ndipatri/RoboGaggia/MyApplication/gaggia1.jpg

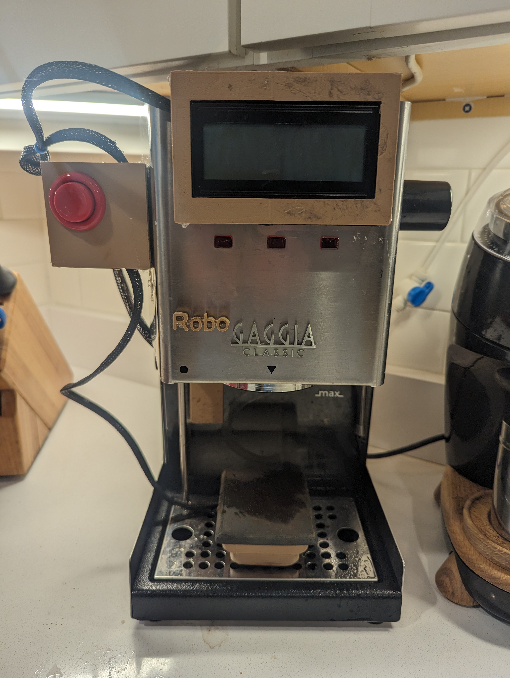
MyApplication/gaggia1.jpg
