ndipatri/RoboGaggia/3DPrints/gaggiaPhoneMount_disk.stl

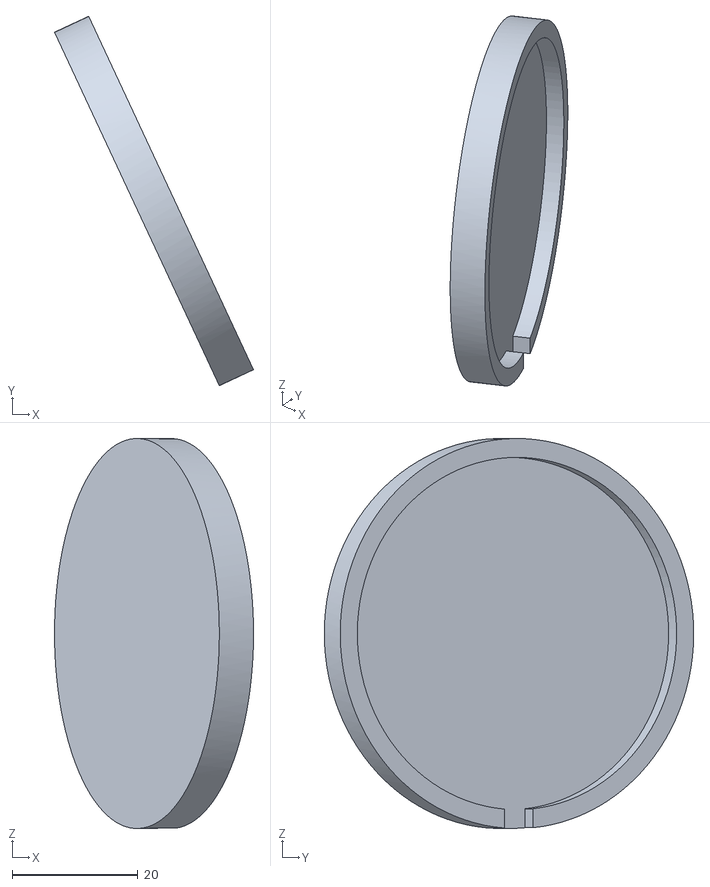
[picture p12: CAD file, 2025-05-02]
3DPrints/gaggiaPhoneMount_disk.stl
31.6 x 58.7 x 62.0
