ndipatri/RoboGaggia/3DPrints/gaggiaPhoneMount_body.stl

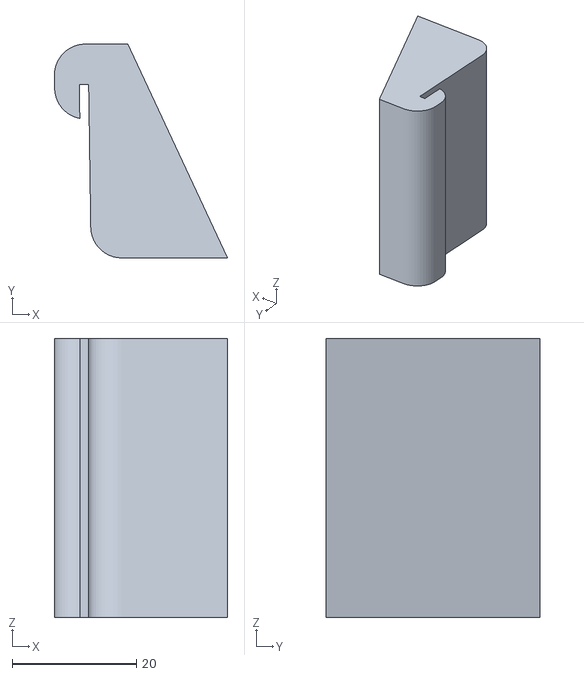
[picture p13: CAD file, 2025-05-02]
3DPrints/gaggiaPhoneMount_body.stl
27.9 x 34.5 x 45.0
