ndipatri/RoboGaggia/3DPrints/gaggiaArmature.stl

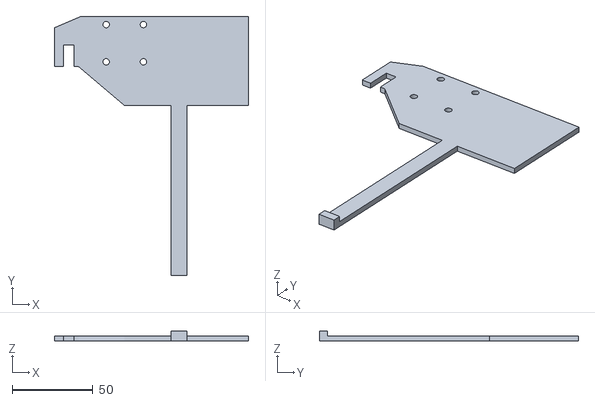
[picture p14: CAD file, 2025-05-02]
3DPrints/gaggiaArmature.stl
120.0 x 160.0 x 6.00
