ndipatri/RoboGaggia/3DPrints/gaggia3PCB_internalSupport.stl

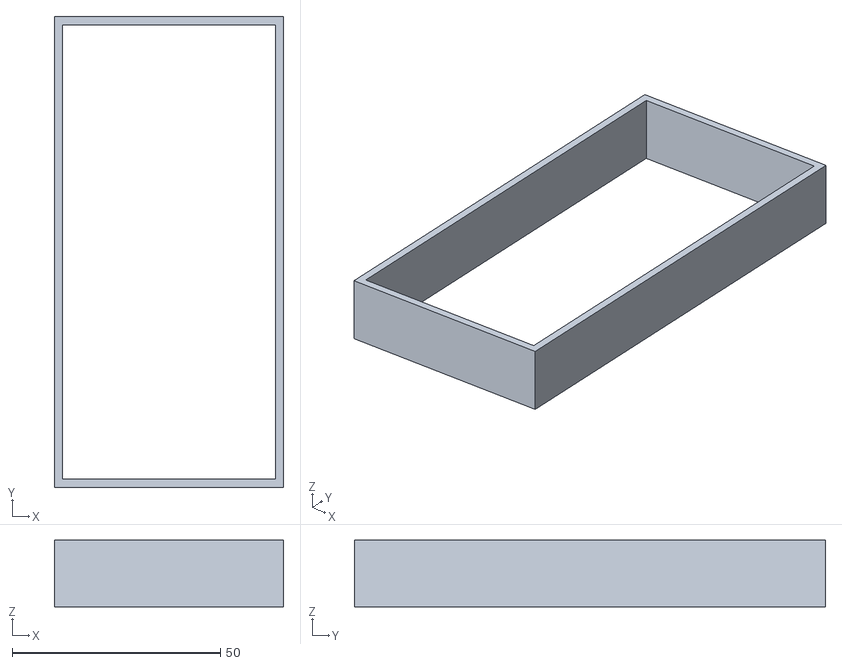
[picture p15: CAD file, 2025-05-02]
3DPrints/gaggia3PCB_internalSupport.stl
55.0 x 113.0 x 16.0
