ndipatri/RoboGaggia/3DPrints/gaggia3Power_lid.stl

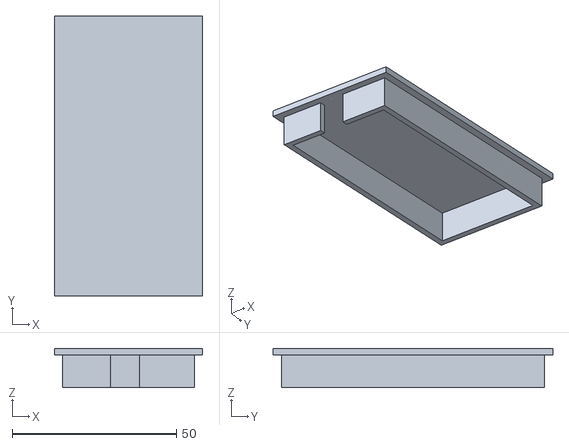
[picture p16: CAD file, 2025-05-02]
3DPrints/gaggia3Power_lid.stl
45.0 x 85.0 x 12.0
