ndipatri/RoboGaggia/3DPrints/gaggia3PCB_lid.stl

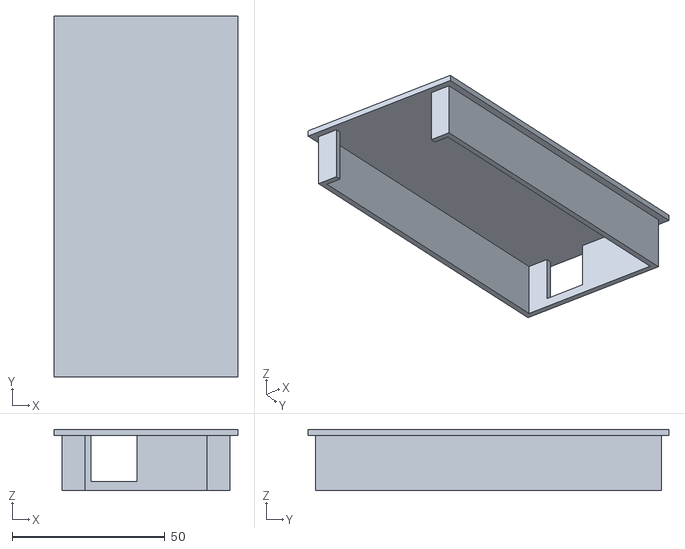
[picture p17: CAD file, 2025-05-02]
3DPrints/gaggia3PCB_lid.stl
60.0 x 118.0 x 20.0
