ndipatri/RoboGaggia/3DPrints/gaggiaPCB.stl

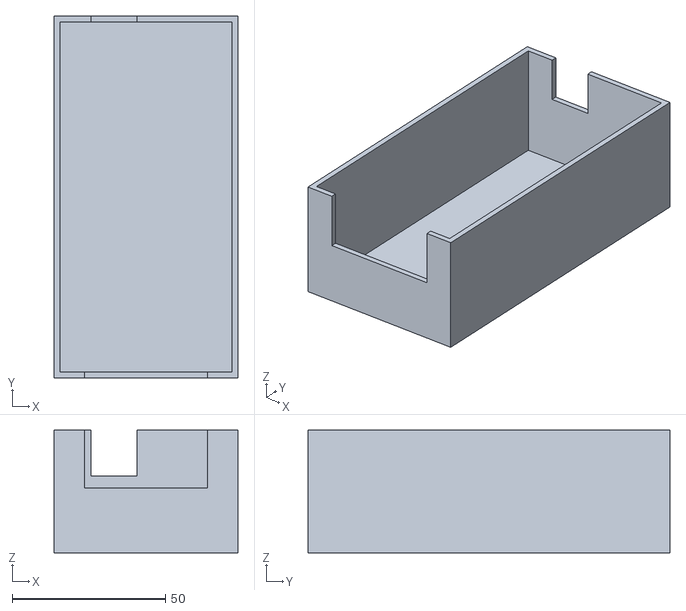
[picture p18: CAD file, 2025-05-02]
3DPrints/gaggiaPCB.stl
60.0 x 118.0 x 40.0
