ndipatri/RoboGaggia/3DPrints/gaggia3Power.stl

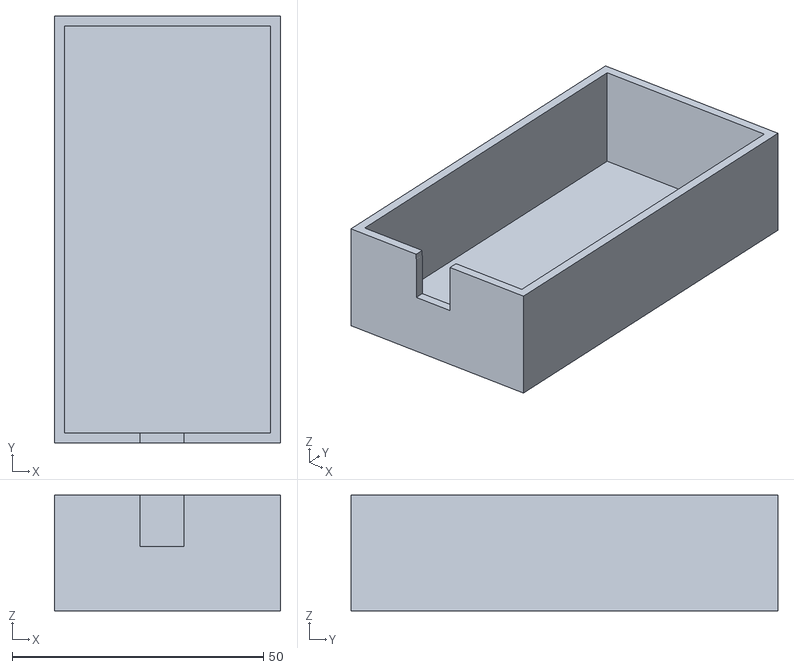
[picture p19: CAD file, 2025-05-02]
3DPrints/gaggia3Power.stl
45.0 x 85.0 x 23.0
