ndipatri/RoboGaggia/3DPrints/scaleTop.stl

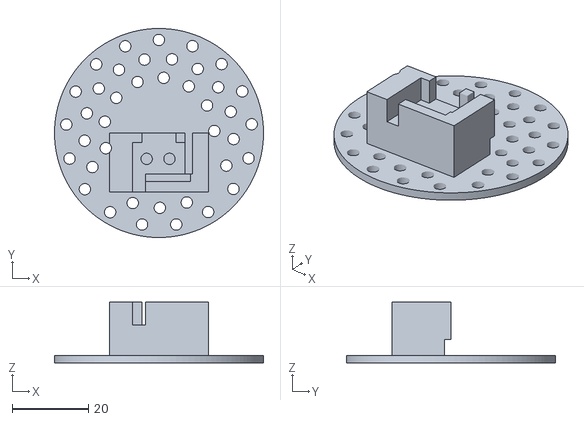
[picture p20: CAD file, 2024-08-15]
3DPrints/scaleTop.stl
55.0 x 55.0 x 16.0
