ndipatri/RoboGaggia/3DPrints/scaleBottom.stl

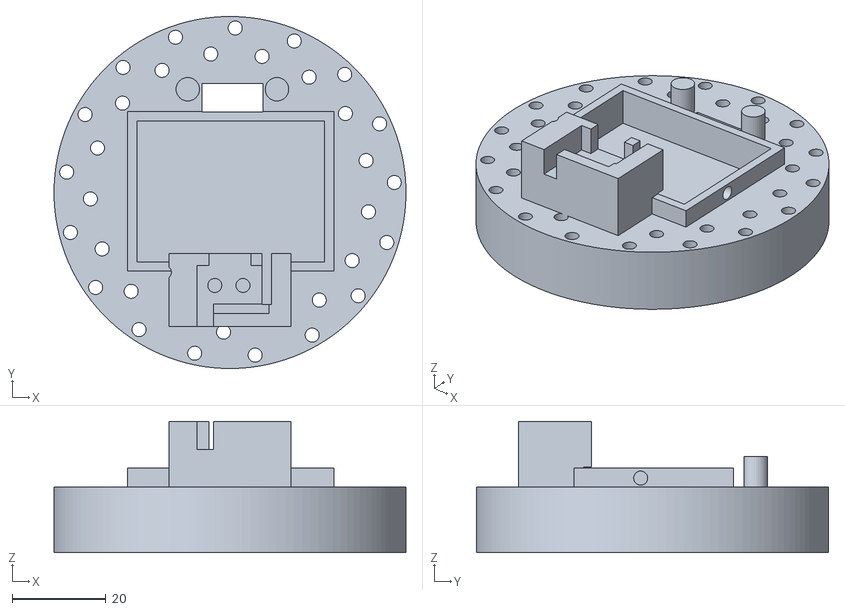
[picture p21: CAD file, 2024-08-15]
3DPrints/scaleBottom.stl
75.0 x 75.0 x 28.0
