ndipatri/RoboGaggia/3DPrints/waterSensorMount.stl

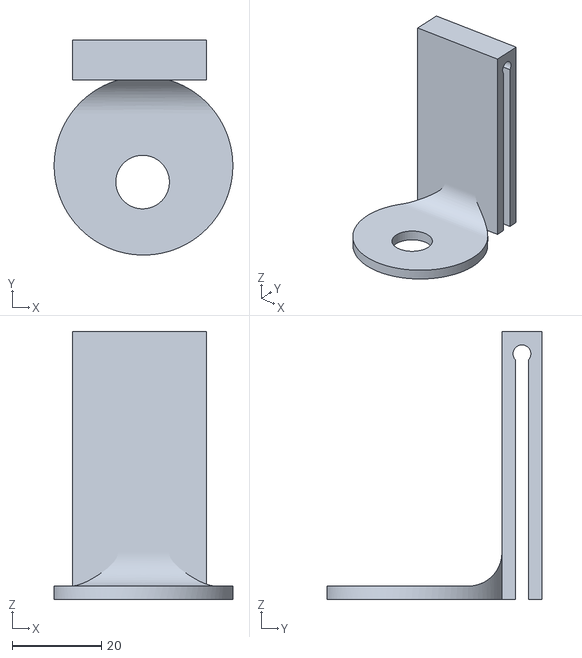
[picture p22: CAD file, 2023-02-01]
3DPrints/waterSensorMount.stl
40.0 x 48.2 x 60.0
