ndipatri/RoboGaggia/3DPrints/valveHanger.stl

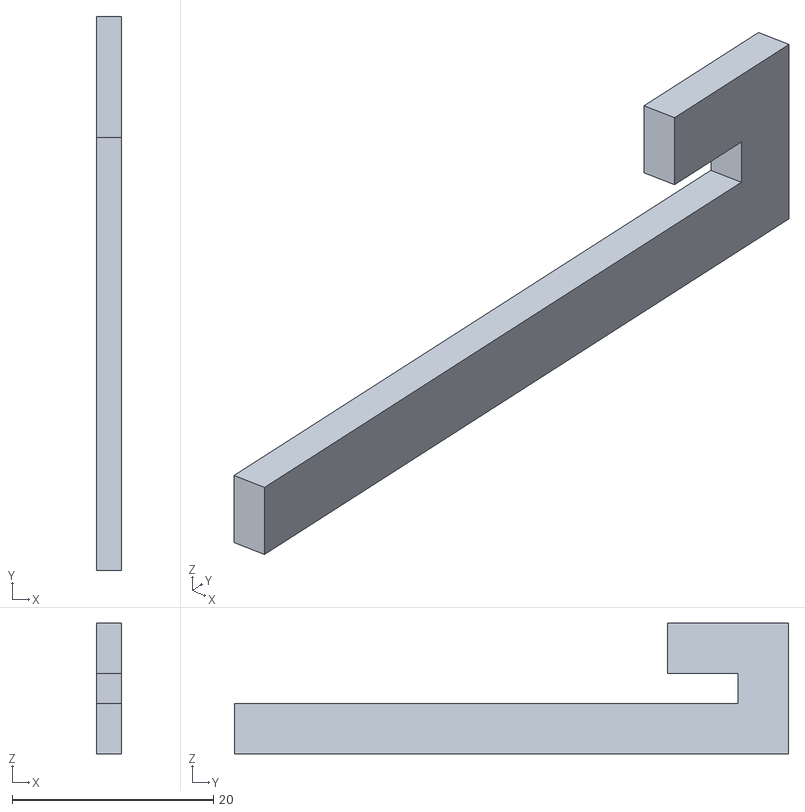
[picture p23: CAD file, 2022-10-07]
3DPrints/valveHanger.stl
2.50 x 55.0 x 13.0
