ndipatri/RoboGaggia/3DPrints/valveBody.stl

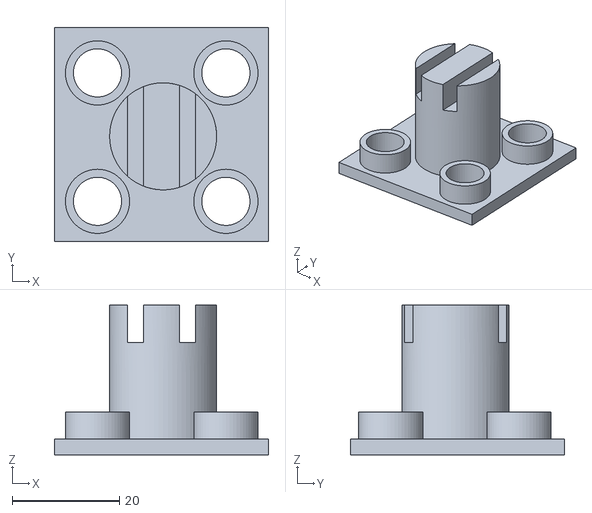
[picture p24: CAD file, 2022-10-07]
3DPrints/valveBody.stl
40.0 x 40.0 x 28.0
