ndipatri/RoboGaggia/media/pressureCalibration.png

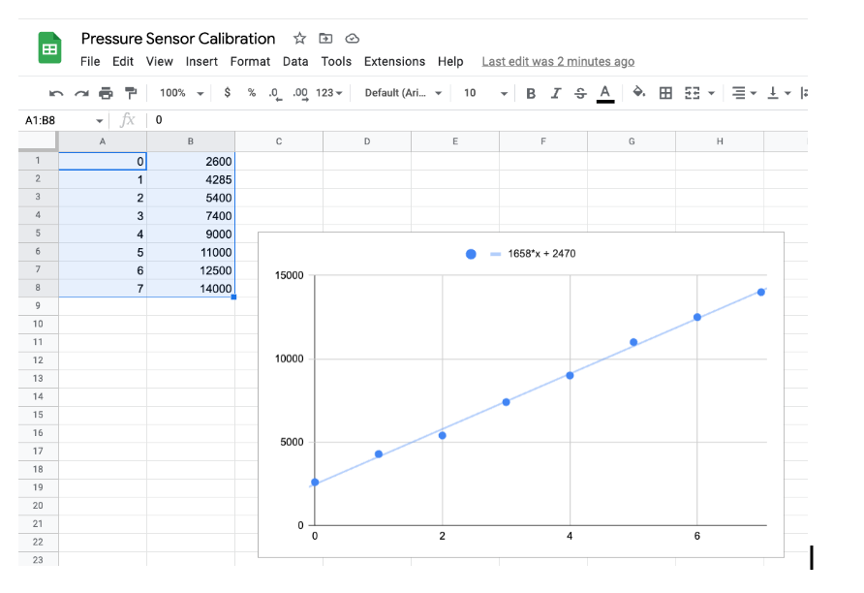
media/pressureCalibration.png
