ndipatri/RoboGaggia/src/components/Common.h

#ifndef CORE_H
#define CORE_H

#include <Arduino.h>

enum GaggiaStateEnum {
  SLEEP,
  PREHEAT, 
  CLEAN_OPTIONS , 
  MEASURE_BEANS ,  
  TARE_CUP_AFTER_MEASURE , 
  HEATING_TO_BREW , 
  PREINFUSION , 
  BREWING , 
  DONE_BREWING , 
  PURGE_BEFORE_STEAM_1, 
  PURGE_BEFORE_STEAM_2, 
  PURGE_BEFORE_STEAM_3, 
  HEATING_TO_STEAM , 
  STEAMING , 
  DESCALE,
  COOL_START , 
  COOLING , 
  COOL_DONE , 
  GROUP_CLEAN_1, 
  GROUP_CLEAN_2, 
  GROUP_CLEAN_3, 
  BACKFLUSH_INSTRUCTION_1 , 
  BACKFLUSH_INSTRUCTION_2 , 
  BACKFLUSH_INSTRUCTION_3 , 
  BACKFLUSH_CYCLE_1 , 
  BACKFLUSH_CYCLE_2 , 
  BACKFLUSH_CYCLE_DONE , 
  HEATING_TO_DISPENSE , 
  DISPENSE_HOT_WATER , 
  IGNORING_NETWORK , 
  JOINING_NETWORK , 
  NA // indicates developer is NOT explicitly setting a test state through web interface
};

// Specific details about the particular state we are in.  
struct GaggiaState {
   int state;   

   // ************
   // WARNING: this cannot be done at the same time (or even in an adjacent state)
   // to dispensing water... i have no clue why..
   // ************
   boolean  fillingReservoir = false;

   boolean  brewHeaterOn = false;
   boolean  steamHeaterOn = false;
   boolean  hotWaterDispenseHeaterOn = false;
   boolean  measureTemp = false;
   boolean  tareScale = false;
   boolean  waterThroughGroupHead = false;
   boolean  waterThroughWand = false;
   boolean  recordWeight = false;

   long stateEnterTimeMillis = -1;
   long stateExitTimeMillis = -1;
   
   // an arbitrary timer that can be used to schedule
   // future events within a state.
   float stopTimeMillis = -1;

   // An arbitrary counter that can be used within a state.
   int counter = -1;
   int targetCounter = -1;
};

// This contains both instantaneous metrics (e.g. measuredWeight) and other metrics that we want to measure
// over a longer period than the system poll interval (e.g. flowRateGPS.. since we want this to be measured for
// as close to a second as possible for accuracy)
struct Telemetry {  
  int id;
  String stateName;
  double measuredWeightGrams = 0;
  double measuredPressureBars = 0.0;
  double pumpDutyCycle = 0.0;
  double flowRateGPS = 0.0;
  double brewTempC = 0.0;
  int shotsUntilBackflush = 0;
  int totalShots = 0;
  int boilerState = 0;    
};

extern int BACKFLUSH_BREW_COUNT_EEPROM_ADDRESS;
extern int TOTAL_BREW_COUNT_EEPROM_ADDRESS;
extern int SETTINGS_EEPROM_ADDRESS;

void commonInit();

void publishParticleLogNow(String group, String message);

void publishParticleLog(String group, String message);

int turnOnTestMode(String _na);

int turnOffTestMode(String _na);

int enterDFUMode(String _na);

extern boolean isInTestMode;

#endif
