ndipatri/RoboGaggia/(commit log)

2022-07-28 Continue work on brew/steam heater
2022-08-20 temp kinda works (no units).. need to calibrate scale now...
2022-08-24 short/long button pressed dialed in.
    [roboGaggia.ino]
2022-08-28 First cut.. adding 'SINGLE CUP' state.
2022-08-30 adding ability to 'pause' cool state to empty cup.. in case water is sooo hot it requires multiple cups to cool down... NOT TESTED YET!
2022-09-11 first cut at using water reservoir solenoid and I2C button!
2022-09-11 adding SparkFun Qwiic Button library and supporting code...
    Freeing up PIN for water solenoid!
2022-09-18 working water sensor and solenoid
2022-09-26 fix water reservoir fill issues.
    [roboGaggia.ino]
2022-09-26 add heater indication.. trying to figure out why steam heat is unbound.
2022-09-26 add 'return to home after 10 minutes' and 'flowRate' functionality.
2022-09-26 more flow rate fixes.
    [roboGaggia.ino]
2022-09-26 flow rate tweaks
2022-09-29 hello state wasn't properly recording weight so 'water too hot' decision wasn't beign made with accurate info.
    [roboGaggia.ino]
2022-10-02 flow control works but duty cycle is goofy.
2022-10-04 finally got the TRIAC working for flow control...
2022-10-15 I'm going to use a PID library and I'm going to use a pressure sensor and use these to modulate the AC dimmer duty cycle I'm also going to use the same P ID library for my existing heater code as I r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
    [roboGaggia.ino]
2022-10-22 brewing works with PID library instead of custom PID implementation.
2022-10-22 ready for the pressure sensor!
    (still need to calibrate for the sensor)
2022-10-25 before heater PID fixes.
    [roboGaggia.ino]
2022-10-25 Fixed issue with configuration of heater PID.
    [roboGaggia.ino]
2022-11-21 installation of pressure guage.
2022-11-23 tuning new pressure sensor, water level sensor changes.
2022-11-23 updating documentation for new water sensor level and pressure sensor.
    [waterSensor.stl, waterSensorClip.stl, waterSensorLid.stl, waterSensorMount.stl]
2022-11-23 update schematic
2022-11-24 update documentation to include sensor calibration.
2022-11-25 begin shell for clean function.
    Changed preinfusion so it only can use 30% duty cycle so the
    water velocity is kept low during preinfusino.
2022-11-26 working version of clean feature.
    A bit of PID tuning.
2022-11-27 PID tuning!
2022-11-27 more PID tuning and documentation.
2022-11-27 PID animated GIF, Starting telemetry w/ (using adafruit.io)
2022-11-28 add TELEMETRY_ENABLED feature flag.
    Reduced backflush pressure.
2022-11-28 feature flag fix..
    Stopped MQTT retry.. made it best-effort for now.
    [roboGaggia.ino]
2022-11-28 add error when mqtt fails
    [roboGaggia.ino]
2022-12-04 doc updates.. added 'minimal' filter for weight
2022-12-06 reduce weight average time since the scale has been fixed.
    [roboGaggia.ino]
2022-12-06 adding brewTemp and flowRate to telemetry.
2022-12-07 add flowRate as input to brew PID
2022-12-07 flow profiling
2022-12-20 -refactor to include separate cpp file for each component. -tuned PID a bit (dialed down P).. also, made infusion flow based instead of time based. -making MQTT connection more robust. adding ping.
2023-01-04 add PID values to telemetry, set PID values to .2, 1, 2
2023-01-05 software OPV (overflow prevention) feature.
    [WaterPump.cpp]
2023-01-07 theory that residual pressure from previous brew is screwing up start of brew.
    so release the dispnese valve before we start pumping.
2023-01-07 add ability to get instant water pressure measurement.
2023-01-08 Reduced 'hot water' temp to 110C (from 140).
    Increased minimum duty cycle from 30 to 40 because
    pre-infusion starts with nothing for too long.
    [Common.h, Heater.cpp, Heater.h, State.cpp, WaterPump.cpp]
2023-01-18 Lower hot water temp so it's not so steamy, Found bug in PID library whereby if you set MIN and MAX to equal, it ignores the call altogether!, Increased PREINFUSION exit criteria to 2grams, Added Cur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
    [Common.cpp, Common.h, Heater.cpp, Scale.cpp, State.cpp, WaterPump.cpp]
2023-01-22 add retry to MQTT connect, fixed preinfusion duty cycle bug.
    [State.cpp, WaterPump.cpp, WaterPump.h]
2023-01-26 add boiler fill stage before ad-hoc steam, 19g shot
2023-01-30 adding PCB Gerber design files.
2023-01-30 new schematic.
2023-02-01 updated water sensor mount
    [waterSensorMount.stl]
2023-02-10 Adding new hello state for when you first turn on gaggia. In this state, it actually heats up boiler.. After 30 minutes, it will redirect to normal 'hello' state which does NOT start the boiler.
2023-03-05 fixed timing of flowRate and Telemetry acquisition.
    [Scale.h, State.cpp, Telemetry.cpp, Telemetry.h, WaterPump.cpp, WaterPump.h]
2023-04-22 more fixes for displaying numbers. (ugly code alert)
    [Scale.cpp, Scale.h, State.cpp]
2023-05-14 update PCB images.. increase brew temp.
2023-05-14 updated gerber files
2023-05-14 adding hangers to attach PCB circuit and power box to back of gaggia.
    [PCB_hanger.stl, power_hanger.stl]
2023-05-19 'long press' time was too short. Removed unnecessary temp display when loading beans.
    [State.cpp, UserInput.cpp]
2023-06-20 Added timer and preinfusion/extraction report after brew...
    This makes it easier to dial in a grind size when you can very
    easily quantify these times.
2023-06-26 updated LCD so it can hang from front of gaggia.
    [lcdBottom.stl]
2023-08-24 opsie..forgot this one.
    [PCB_lid.stl]
2023-08-25 updated PCB body
    [PCB_body.stl]
2023-08-26 dimmer is no longer a separate print... it's part of PCB.
    [dimmer.stl]
2023-08-27 new scale updates.
    [scaleBottom.stl, scaleLid.stl, scaleTop.stl]
2023-09-08 Adding 'SLEEP' mode.
    This replaces the existing HELLO mode.
    When user pressed button to leave SLEEP,
    they move to the PREHEAT mode.
    Thanks to https://www.linkedin.com/in/christopher-wilson-237405152/ for
    help on this idea.
    [Common.h, State.cpp, State.h, roboGaggia.ino]
2023-09-08 When water reservoir is low, the last column of the second line on display will show 'W'.
    This is so even if a RoboGaggia build does NOT
    have the water solenoid, the user will know when
    the water level is low (if they've installed the sensor)
2023-09-09 Displaying both preinfusion and current brew time during brewing.
2023-09-09 adding 'B' backwash indicator.. it will keep track of the number of brews cycles and when backflush is done, it will automatically reset the counter.. uses EEPROM so this counter will persist power c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
    [State.cpp, State.h]
2023-09-10 Removed Water Level indicator.. duh, need two sensors for that.
    Removed 'B' backflush as that's also silly.. Need to add
    a 'messages' interim screen before brewing.. will do that
    next.
2023-11-14 Emitting BLE telemetry using UART BLE Service.
2023-11-27 able to receive 'short' and 'long' commands from BLE.
    [Bluetooth.cpp, Bluetooth.h, Telemetry.cpp, UserInput.cpp, UserInput.h]
2023-11-27 fixed annoying backflush bug where instructions were being skipped!
    [State.cpp]
2023-12-29 We were not reconnecting to MQTT after going to sleep. fixed this bug due to simple error.
    [State.cpp]
2023-12-29 group head cleaning now auto stops after a couple seconds.
2024-01-01 reduce group head clean time... was getting too hot with the towel!
    [State.cpp]
2024-01-21 Switched from Pulse Shape Modulation to Pulse Skip Modulation.
    Separated flowRate and Telemetry lifecycles.. Improved
    flowRate PID operation.
    [Heater.cpp, Scale.cpp, Scale.h, State.cpp, Telemetry.cpp, Telemetry.h, WaterPump.cpp, WaterPump.h]
2024-02-03 The 'done brewing' state now needs to be explicitly advanced by user.. this is so the mobile app can show the telemetry graph of last brew.
    Still twerking brew PID
2024-02-06 more PID tuning
2024-02-26 Only enable MQTT if 'AIO_USERNAME' is defined in Secrets.h
    Otherwise, BLE is used.
    I'm keeping MQTT as it might be useful for PID tuning (for now)
2024-05-06 adding support for 'target' values.. so each attribute can have the format: <currentValue>:<targetValue>.. and these will be displayed while brewing..
    Currently, i'm just doing weight.. so we can see, while brewing, what the
    target weight is.
2024-05-11 Huge improvement with scale! it's MUCH faster now. It also calibrates every time roboGaggia is restarted.
    Only caveat at this time is the Scale.KNOWN_CUP_WEIGHT_GRAMS value must be set to teh KNOWN weight
    of the espresso cup used to pull shots on the scale. This will need to be reconfigurable via Particle Cloud sooner than later.
2024-05-12 Fix Particle Cloud support for PID tuning
    [Scale.cpp, State.cpp, WaterPump.cpp]
2024-08-15 working on documentation
    [buttonBody.stl, buttonLid.stl, junctionBox.stl, lcdBezel.stl, lcdBottom.stl, lcdTopNot.stl, scaleBottom.stl, scaleLid.stl]
2024-08-20 remove all vestiges of MQTT! It's only required for simulating on the mobile side, not the real Gaggia device anymore.
2024-08-22 adding phone hanger.
    [phoneHanger_pier.stl, phoneHanger_strut.stl]
2024-10-09 fixes after MQTT removal! oopsie!
    [Scale.cpp, State.cpp, UserInput.h, roboGaggia.ino]
2024-11-04 support for composite Temp telemetry (e.g. 'currentTemp:targetTemp')
2024-11-10 support for weightToBean ratio and added current:target brew temp.
2024-12-24 Remove brew themocouple/controller.. We only need one for the Gaggia! The two were originally necessary as these were thermostats and would engage the brew and steam circuitry.. Now that we are contr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
2025-03-07 Decided a simple voltage-divider was all i needed instead of a separate ADC! duh!
2025-05-02 more doc updates for gaggia small refactor.
    [PCB_body.stl, PCB_hanger.stl, PCB_lid.stl, Power_body.stl, Power_lid.stl, gaggia3PCB_internalSupport.stl, gaggia3PCB_lid.stl, gaggia3Power.stl]
2025-05-02 more doc updates
    [gaggiaPhoneMount_body.stl, gaggiaPhoneMount_disk.stl]
